novamostra/network_watchdog/(commit log)

2023-01-07 Changed schematic picture
2023-01-08 Updated schematic
2023-01-12 Fixed schematic
2023-10-13 Update NetworkWatchdog_1_0_0.ino
    Fixed "error: control reaches end of non-void function [-Werror=return-type] 451 | } | ^ cc1plus.exe: some warnings being treated as errors" which caused because the processor function didn't had an else statement.
    [NetworkWatchdog_1_0_0.ino]
